jeremygustafson/StargateAtlantis/STLs/SGA power adapter holder - Whole box.stl

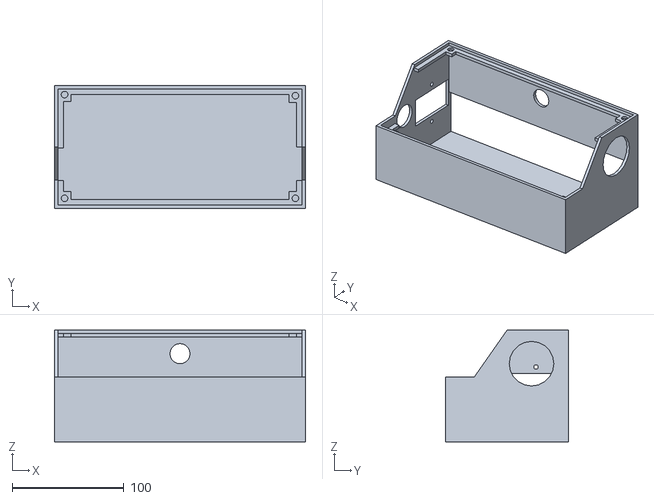
[picture p1: CAD file, 2022-01-02]
STLs/SGA power adapter holder - Whole box.stl
225.0 x 110.0 x 100.0
