jeremygustafson/StargateAtlantis/STLs/SGA power adapter holder part 2.stl

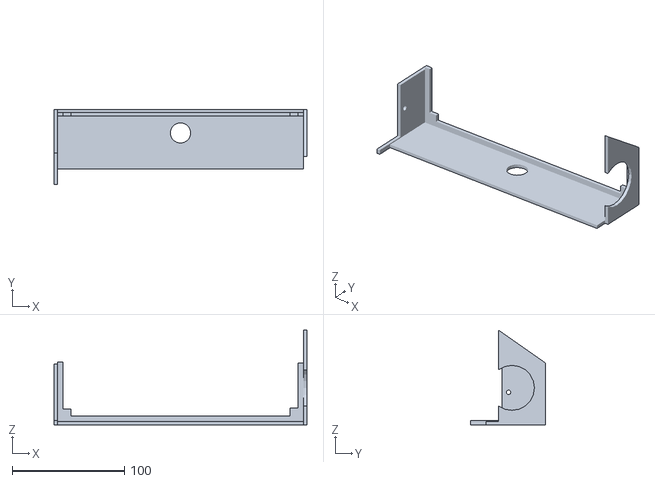
[picture p2: CAD file, 2022-01-02]
STLs/SGA power adapter holder part 2.stl
225.0 x 67.0 x 84.4
