jeremygustafson/StargateAtlantis/STLs/sga_base_top_left_revised.stl

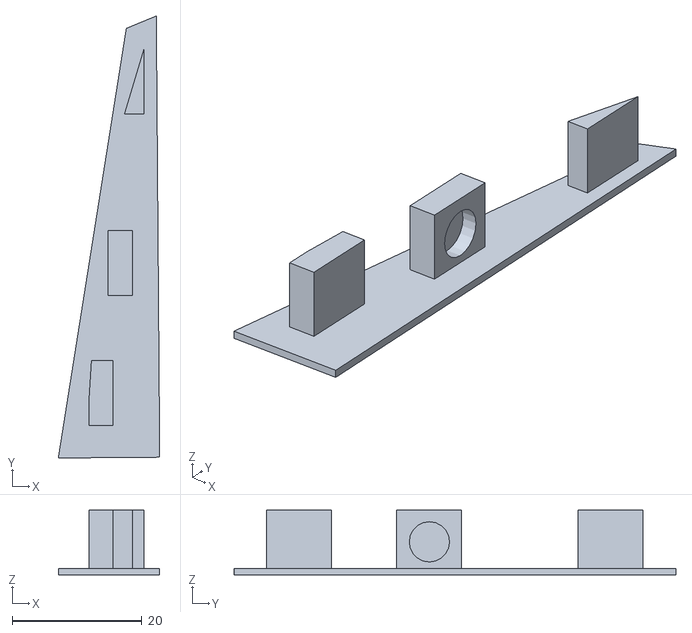
[picture p3: CAD file, 2022-01-02]
STLs/sga_base_top_left_revised.stl
15.6 x 68.1 x 10.0
