jeremygustafson/StargateAtlantis/STLs/SGA power adapter holder part 1.stl

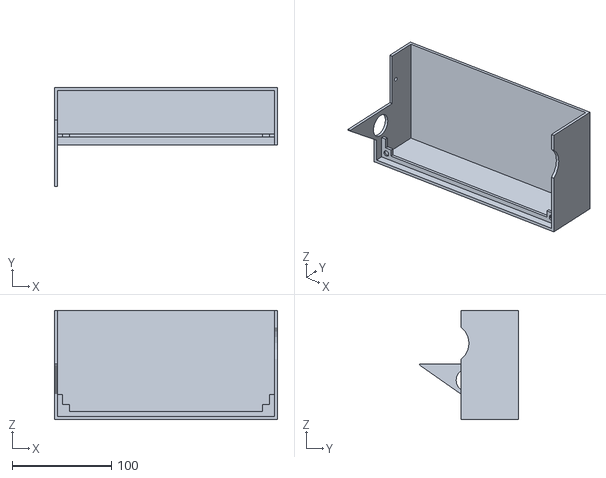
[picture p4: CAD file, 2022-01-02]
STLs/SGA power adapter holder part 1.stl
225.0 x 100.0 x 110.0
