jeremygustafson/StargateAtlantis/STLs/SGA power adapter holder - cover - SGA logo.stl

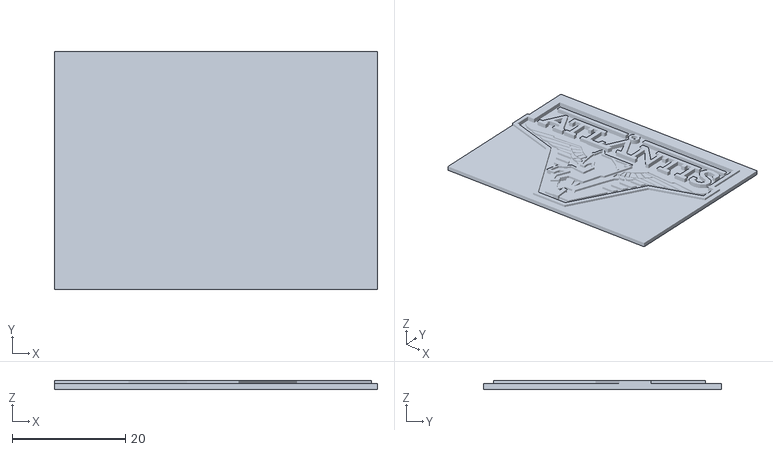
[picture p5: CAD file, 2022-01-02]
STLs/SGA power adapter holder - cover - SGA logo.stl
57.0 x 42.0 x 1.50
