jeremygustafson/StargateAtlantis/STLs/SGA power adapter holder - cover.stl

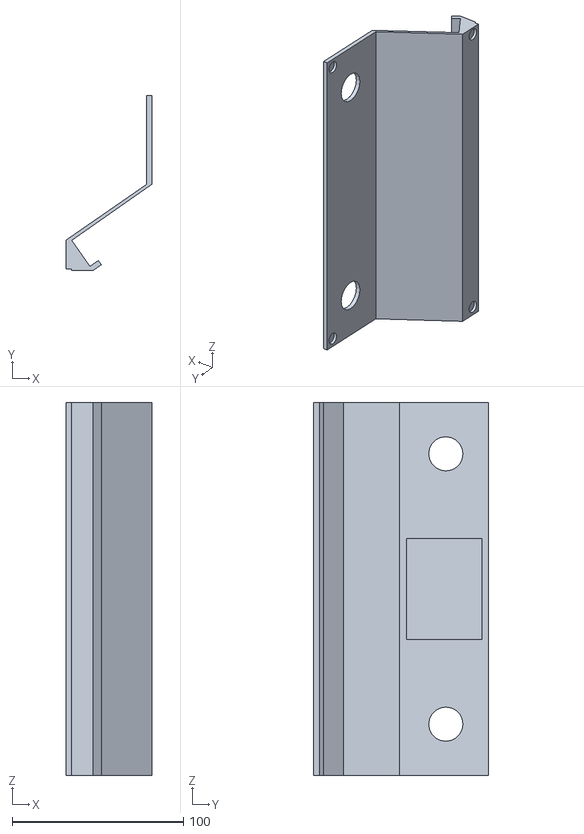
[picture p6: CAD file, 2022-01-02]
STLs/SGA power adapter holder - cover.stl
50.0 x 102.4 x 218.0
